Picatout/pic10f202_music_box/f322_music_box.png

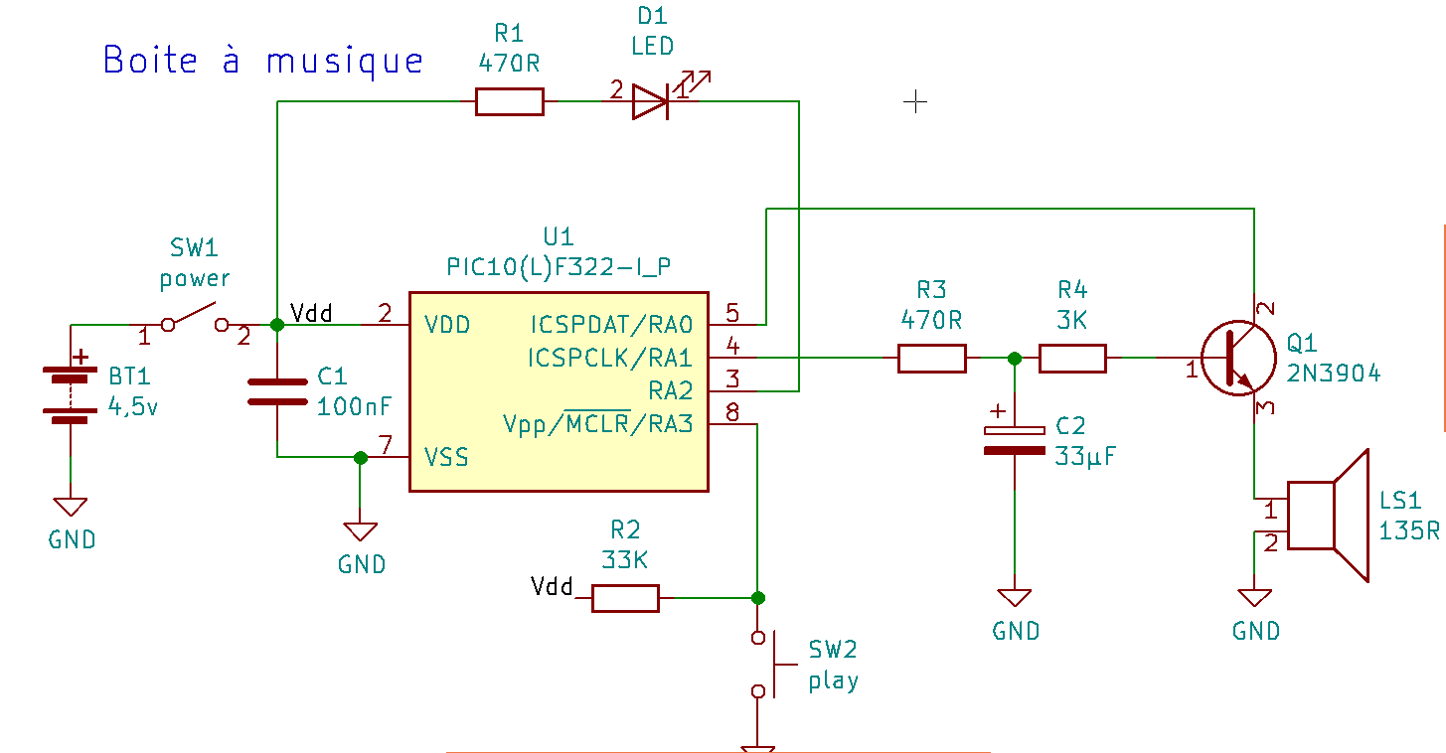
f322_music_box.png
