Picatout/pic10f202_music_box/KiCAD/music_box.sch

## KiCad design KiCAD/music_box.sch (2018-11-30)

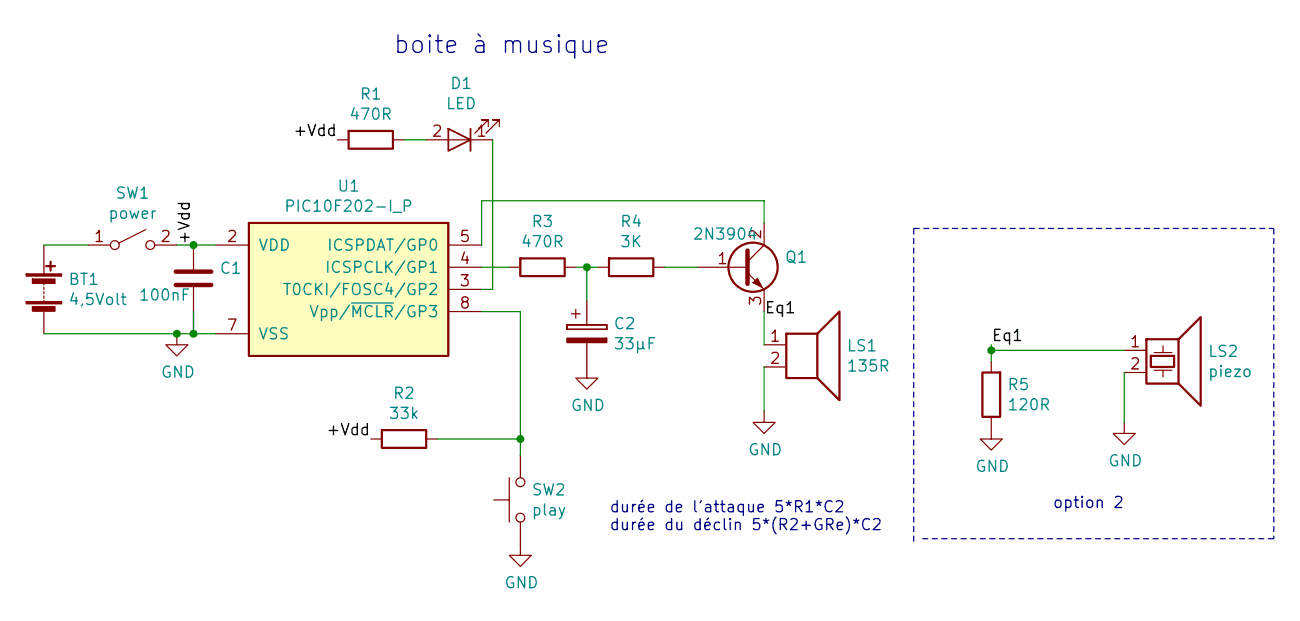
[picture p4: schematic music_box.sch]

Parts:
BT1: 4,5Volt
C1: 100nF
C2: 33µF
D1: LED
LS1: 135R
LS2: piezo
Q1: 2N3904
R1, R3: 470R
R2: 33k
R4: 3K
R5: 120R
SW1: power
SW2: play
U1: PIC10F202-I_P; DIP-8_W7.62mm

Connections:
+Vdd: C1.2, R1.2, R2.2, SW1.2 (B), U1.2 (VDD)
Eq1: LS1.1, LS2.1, Q1.3 (E), R5.2
GND: BT1.2 (-), C1.1, C2.2, LS1.2, LS2.2, R5.1, SW2.1, U1.7 (VSS)
unnamed: BT1.1 (+), SW1.1 (A)
unnamed: C2.1, R3.1, R4.2
unnamed: D1.1 (K), U1.3 (T0CKI/FOSC4/GP2)
unnamed: D1.2 (A), R1.1
unnamed: Q1.1 (B), R4.1
unnamed: Q1.2 (C), U1.5 (ICSPDAT/GP0)
unnamed: R2.1, SW2.2, U1.8 (Vpp/~MCLR~/GP3)
unnamed: R3.2, U1.4 (ICSPCLK/GP1)

Notes on the sheet:
option 2
durée de l'attaque 5*R1*C2 durée du déclin 5*(R2+GRe)*C2
boite à musique
