Picatout/pic10f202_music_box/KiCAD/f322_mb/f322_mb.sch

## KiCad design KiCAD/f322_mb/f322_mb.sch (2018-12-02)

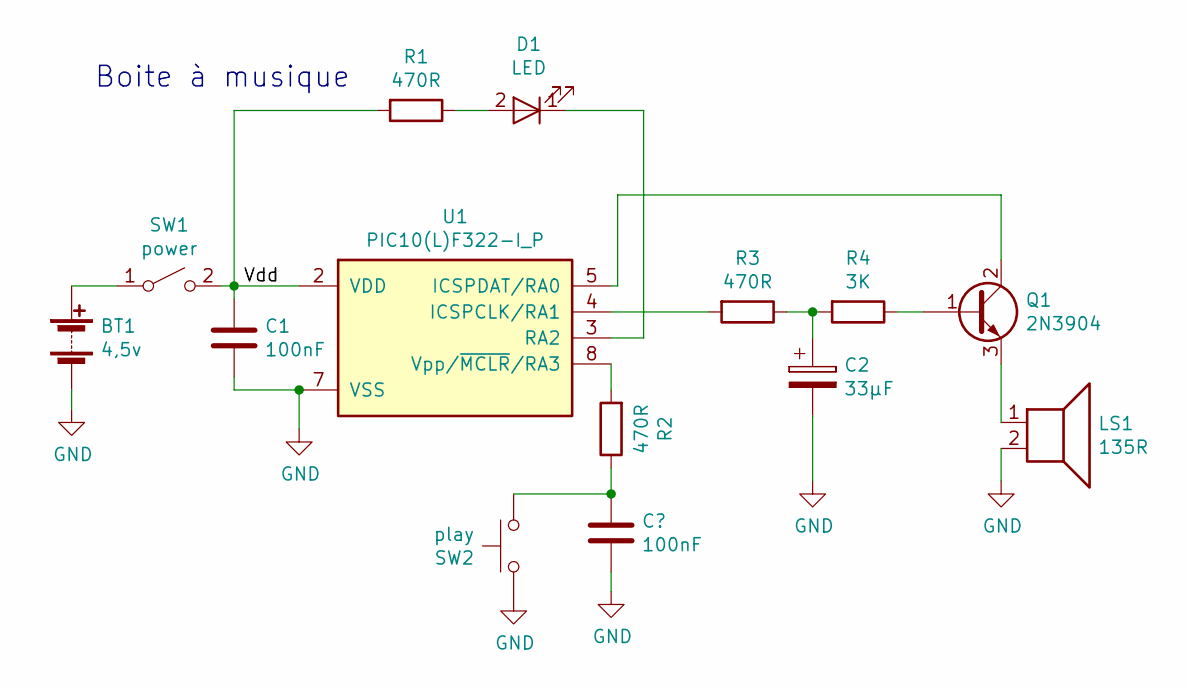
[picture p5: schematic f322_mb.sch]

Parts:
BT1: 4,5v
C1: 100nF
C2: 33µF
D1: LED
LS1: 135R
Q1: 2N3904
R1, R2, R3: 470R
R4: 3K
SW1: power
SW2: play
U1: PIC10(L)F322-I_P; DIP-8_W7.62mm

Connections:
GND: BT1.2 (-), C1.2, C2.2, LS1.2, SW2.1, U1.7 (VSS)
unnamed: BT1.1 (+), SW1.1 (A)
unnamed: C2.1, R3.1, R4.2
unnamed: D1.1 (K), U1.3 (RA2)
unnamed: D1.2 (A), R1.1
unnamed: LS1.1, Q1.3 (E)
unnamed: Q1.1 (B), R4.1
unnamed: Q1.2 (C), U1.5 (ICSPDAT/RA0)
unnamed: R2.1, SW2.2
unnamed: R2.2, U1.8 (Vpp/~MCLR~/RA3)
unnamed: R3.2, U1.4 (ICSPCLK/RA1)
Vdd: C1.1, R1.2, SW1.2 (B), U1.2 (VDD)

Notes on the sheet:
Boite à musique
