Picatout/pic10f202_music_box/(threads)

Thread 1 (2020-12-23):

Music_Box PCB for DIL PIC10F202 et SMD PIC10F322

Mic2015, 2020-12-23:
Voici le lien pour tous les  PCB et les vidéos des 2 versions de Music_Box sur Onedrive
sur les vidéo le son est faible mais en réalité il donne bien

https://1drv.ms/u/s!All38Tl2pzx-jrpczh0Emhe0UwHs8w?e=4ITOuM

Merci à Jacques :)
