Picatout/pic10f202_music_box/(commit log)

2018-11-29 premier commit
    [music_box.kicad_pcb, music_box.sch]
2018-12-01 création d'un projet pour réalisé la même boite à musique en utilisant un PIC10F322
    [f322_mb.kicad_pcb, f322_mb.sch]
2018-12-02 travail sur version pic10f322 de la boite à musique
    [f322_mb.sch]
2018-12-02 complété version pic1f322 de la boite à musique
2018-12-06 nouvelle version de la boite à musique sur PIC12F1572
    [f1572_mb.kicad_pcb, f1572_mb.sch]
2018-12-10 debugging and adding melodies
    [f1572_mb.sch]
2018-12-11 modification to cicircuit diagram. Switched PWM between LED and ENV
    [f1572_mb.sch]
2018-12-14 transfert du projet sur pic12f1572 dans un autre git
    [f1572_mb.kicad_pcb, f1572_mb.sch]
